MartinD-CZ/Lithium-Battery-Utility-Board/photos/20171225_182436.jpg

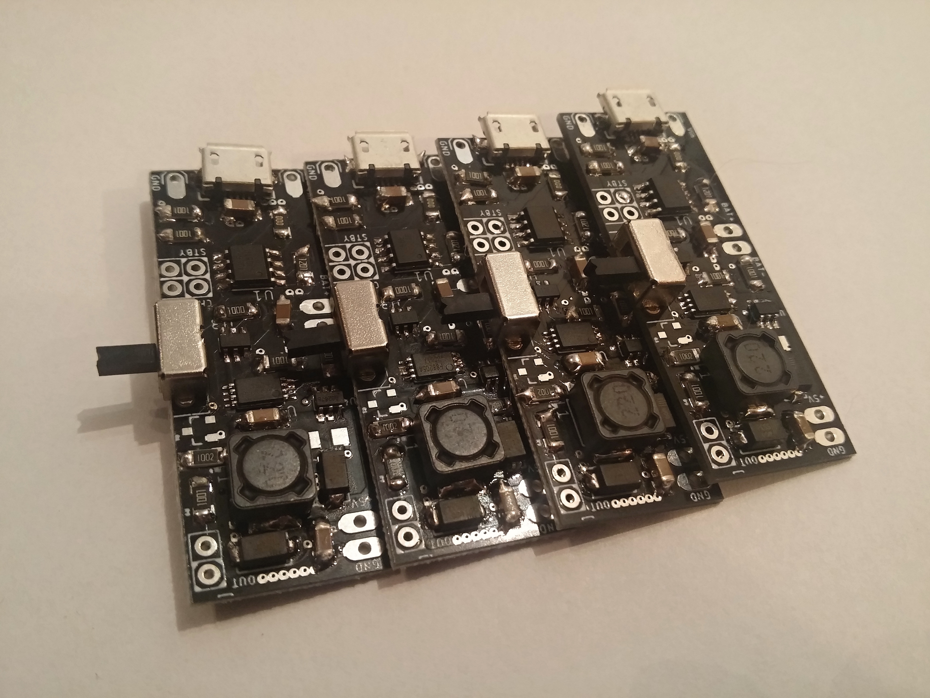
photos/20171225_182436.jpg
