MartinD-CZ/Lithium-Battery-Utility-Board/photos/20171225_180216.jpg

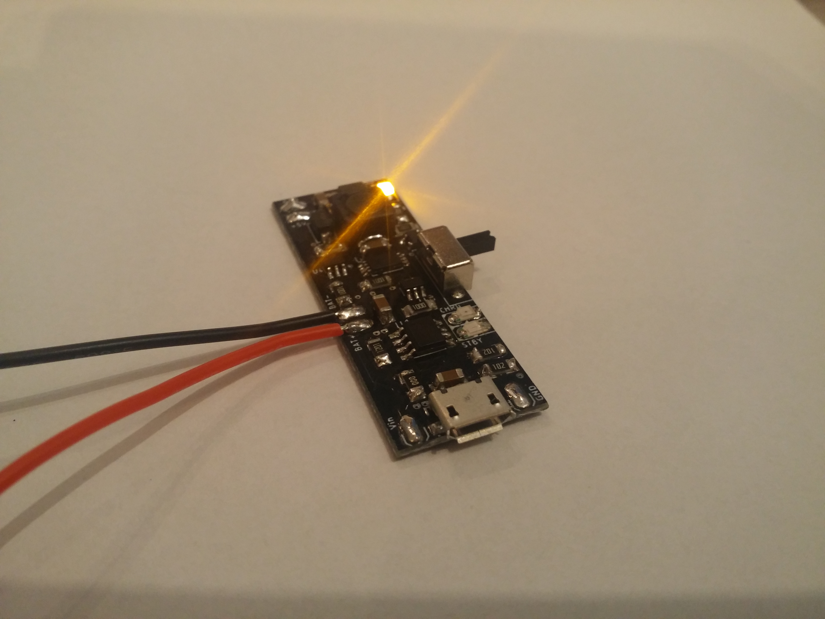
photos/20171225_180216.jpg
