MartinD-CZ/Lithium-Battery-Utility-Board/README.md

# Lithium Battery Utility Board

*see the article [here](http://embedblog.eu/?p=91)!*

versions (see the changelog for more information):
* V1.0 - proven, initial release
* V1.1 - minor tweaks, **not proven**
* V1.2 - major tweaks, proven
