MartinD-CZ/Lithium-Battery-Utility-Board/load_sharing_explanation/pic1.png

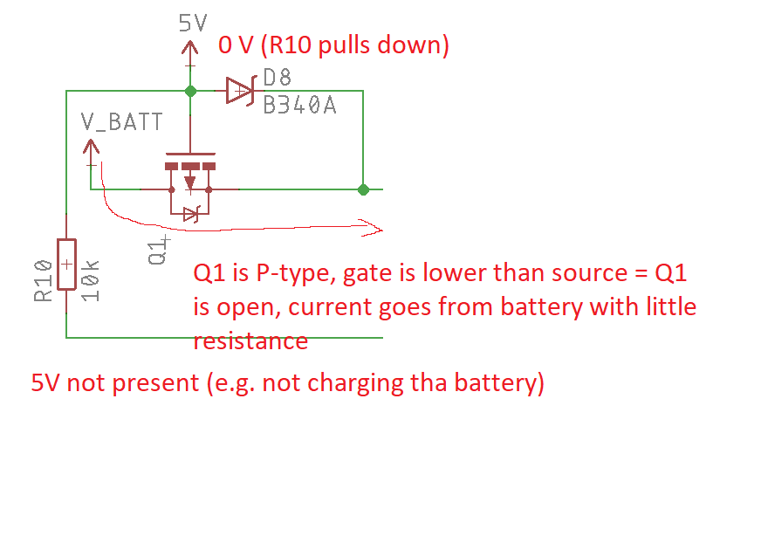
load_sharing_explanation/pic1.png
