MartinD-CZ/Lithium-Battery-Utility-Board/load_sharing_explanation/pic2.png

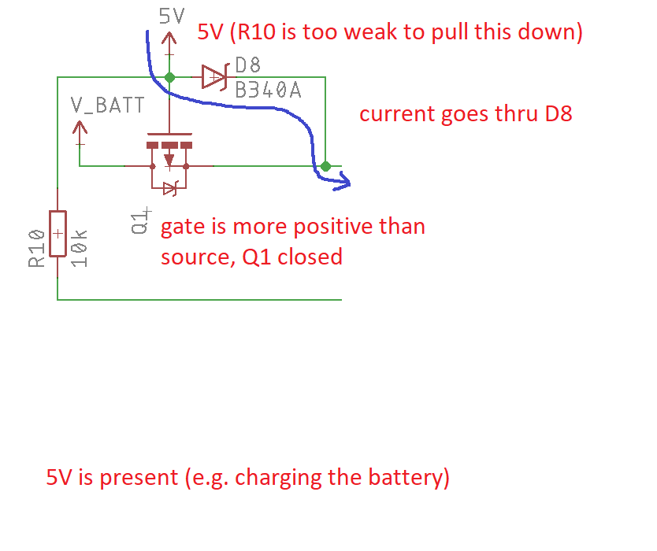
load_sharing_explanation/pic2.png
