MartinD-CZ/Lithium-Battery-Utility-Board/photos/20171225_182255.jpg

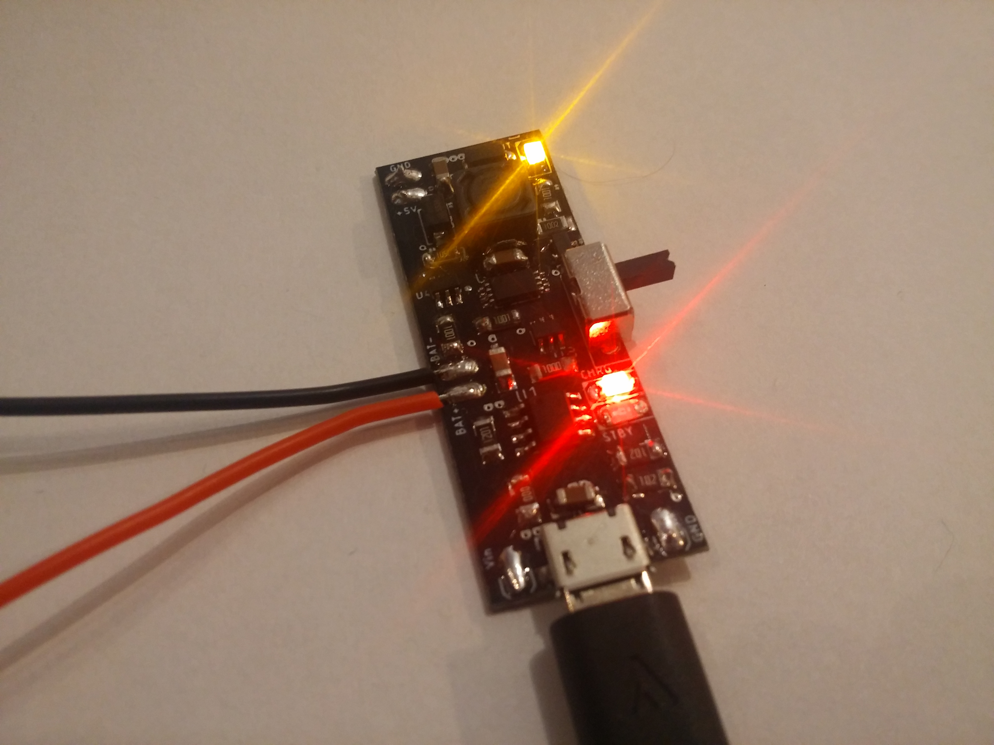
photos/20171225_182255.jpg
