MartinD-CZ/Lithium-Battery-Utility-Board/photos/20171225_182304.jpg

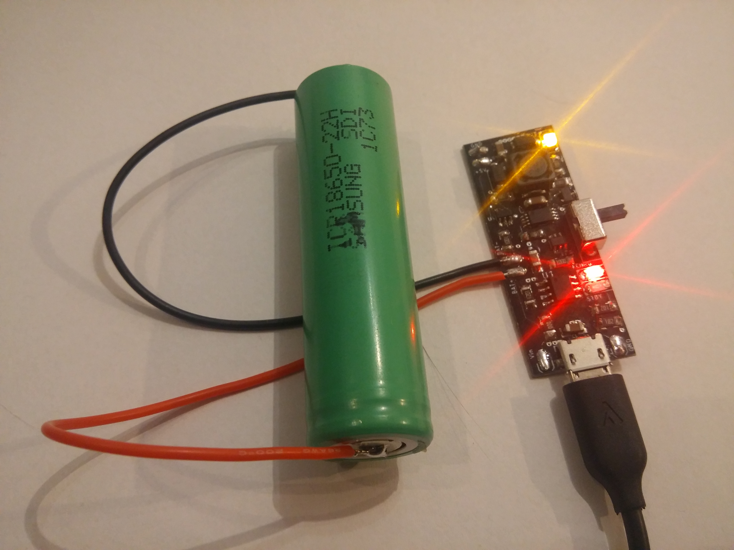
photos/20171225_182304.jpg
