MartinD-CZ/Lithium-Battery-Utility-Board/V12/lithium_battery_manager_v12.brd

## EAGLE design V12/lithium_battery_manager_v12.brd (2018-11-22)

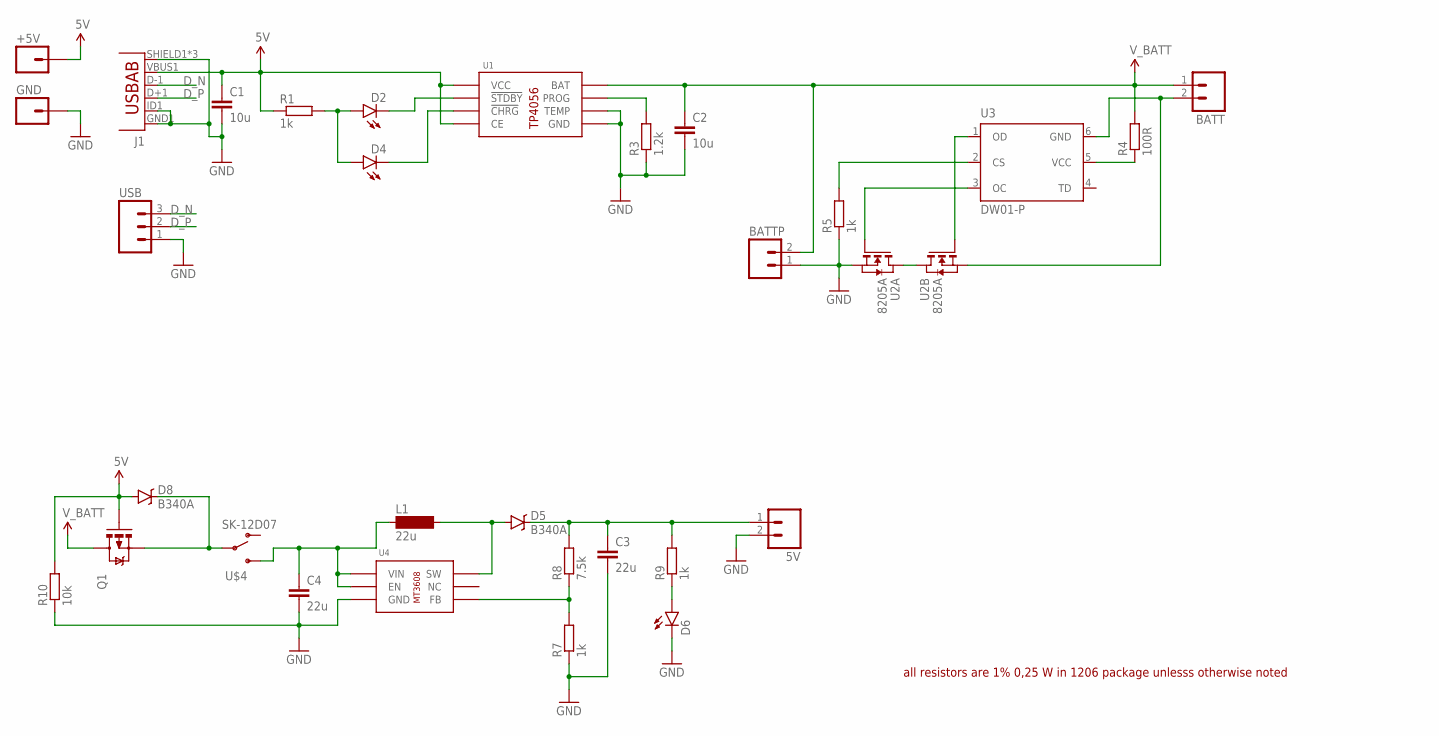
[picture p8: schematic lithium_battery_manager_v12.sch]

Parts:
5V: M02PTH3; 1X02_LONGPADS
+5V: M01OFFSET; 1X01_OFFSET
BATT: M02PTH3; 1X02_LONGPADS
BATTP: M02PTH3; 1X02_LONGPADS
C1, C2: 10u; C1206
C3, C4: 22u; C1206
D2, D4, D6: LED-CONN; LED5MM
D5, D8: B340A; SMA-DIODE
GND: M01OFFSET; 1X01_OFFSET
J1: USB-ABCONN-11794; USB-AB-MICRO-SMD_V03
L1: 22u; MS85
Q1: MOSFET-PCHANNEL; SOT23-3
R1, R5, R7, R9: 1k; R1206
R3: 1.2k; R1206
R4: 100R; R1206
R8: 7.5k; R1206
R10: 10k; R1206
U1: TP4056; SOP8
U2: 8205A; TSSOP8
U3: DW01-P; SOT23-6L
U4: MT3608; SOT23-6
U$4: SK-12D07; SK12SWITCH
USB: M03PTH; 1X03

Connections:
5V: +5V.1, C1.1, D8.A, J1.VBUS1 (VBUS), Q1.1 (G), R1.1, R10.2, U1.4 (VCC), U1.8 (CE)
D_N: J1.D-1 (D-), USB.3
D_P: J1.D+1 (D+), USB.2
GND: 5V.2, BATTP.1, C1.2, C2.2, C3.2, C4.2, D6.K (C), GND.1, J1.GND1 (GND), J1.ID1 (USBID), J1.SHIELD1 (SHIELD), J1.SHIELD2 (SHIELD), J1.SHIELD3 (SHIELD), R3.1, R5.1, R7.1, R10.1, U1.1 (TEMP), U1.3 (GND), U2.2 (S), U2.3 (S), U4.2 (GND), USB.1
unnamed: C4.1, L1.1, U4.4 (EN), U4.5 (VIN), U$4.IN (S)
unnamed: D2.K (C), U1.6 (!STDBY)
unnamed: D2.A, D4.A, R1.2
unnamed: R3.2, U1.2 (PROG)
unnamed: R4.1, U3.5 (VCC)
unnamed: D4.K (C), U1.7 (!CHRG)
unnamed: BATT.2, U2.6 (S), U2.7 (S), U3.6 (GND)
unnamed: U2.1 (D), U2.8 (D)
unnamed: U2.5 (G), U3.1 (OD)
unnamed: U2.4 (G), U3.3 (OC)
unnamed: D5.A, L1.2, U4.1 (SW)
unnamed: R5.2, U3.2 (CS)
unnamed: R7.2, R8.1, U4.3 (FB)
unnamed: D6.A, R9.1
unnamed: D8.C, Q1.2 (S), U$4.P2
unnamed: 5V.1, C3.1, D5.C, R8.2, R9.2
V_BATT: BATT.1, BATTP.2, C2.1, Q1.3 (D), R4.2, U1.5 (BAT)

Notes on the sheet:
all resistors are 1% 0,25 W in 1206 package unlesss otherwise noted

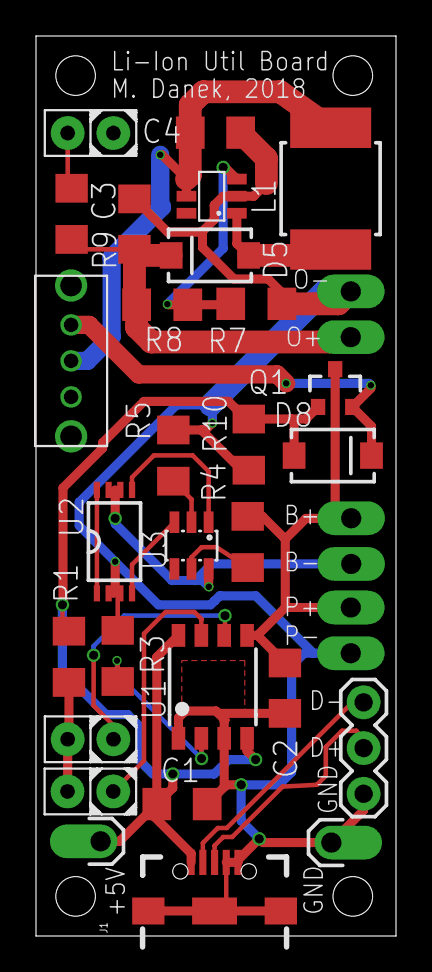
[picture p9: board lithium_battery_manager_v12.brd from above]

Board: 2 copper layers, 20.0 x 50.0 mm, 31 parts (0 on the bottom side), 21 nets.
